paranoidi/gearplate/bracket.scad

// Device end caps for gearplate
// A pair of caps that screw onto the gearplate's 14mm insert grid, one over each end of
// a box-shaped device. Seen from the end, each cap is a hat:
//
//     |------------|      front strap over the device face
//     |  ________  |      end wall, with optional notches open from the plate side
// ----|  |      |  |----  flanges with screws, outboard (screwdriver clears the walls)
//
// Output is in print orientation: both caps lying on their end wall, side by side.

// Device width in mm
device_w = 60;
// Device height (distance between the two caps) in mm
device_h = 100;
// Device depth (plate to front face) in mm
device_d = 25;
// Clearance per side around the device
fit = 0.5;
// Widen the caps by one hole pitch when needed, so the device centres on the plate (D30)
center_x = false;
// Wall, end wall and strap thickness
wall = 3;
// Flange thickness
flange_t = 4;
// How far a cap reaches along the device, end wall included (grows if a screw needs room)
cap_len = 15;
// Screw clearance hole (M3)
screw_d = 3.4;
// Screwdriver / screw head clearance diameter
driver_d = 7;
// Extra margin around the screwdriver
driver_margin = 1;
// Chamfer on all outside edges, holes and notches (0 = sharp)
chamfer = 0.4;

/* [Cutouts, cap A] */
// End-wall notches [w, h, x_offset], open from the plate side, seen from outside with
// the strap on top: x_offset 0 = centred, + = right. [0,0,0] = off.
a_cut1 = [0, 0, 0];
a_cut2 = [0, 0, 0];
a_cut3 = [0, 0, 0];
a_cut4 = [0, 0, 0];

/* [Cutouts, cap B] */
b_cut1 = [0, 0, 0];
b_cut2 = [0, 0, 0];
b_cut3 = [0, 0, 0];
b_cut4 = [0, 0, 0];

/* [Top cutouts] */
// Window in the front strap [w, l, x_offset], open through the cap's end: w across,
// l along the device from its end, x_offset as for notches. [0,0,0] = off. Combines
// with end-wall notches. The cap grows to keep a strap band of at least `top_band` past
// the window.
a_top = [0, 0, 0];
b_top = [0, 0, 0];

/* [Hidden] */
pitch = 14;
// gearplate's board edge gap: flanges reach pitch/2 - edge_gap past the screw, flush
// with the plate edge when a cap sits on the edge hole row
edge_gap = 0.3;
// minimum strap band left past a top cutout
top_band = 15;
$fs = 0.5;
$fa = 5;

// Distance between the left and right hole rows: the smallest multiple of the hole
// pitch that leaves `clear` between each side wall and its screw centre, so both rows
// land on the gearplate grid. center_x makes the count odd (+1 pitch, 7 mm more flange per
// side): a plate has an even number of hole columns, so only an odd span centres on it.
function hole_span(inner_w, wall, clear) = let (k = ceil((inner_w + 2*wall + 2*clear) / pitch))
    pitch * (k + (center_x && k % 2 == 0 ? 1 : 0));
// Side wall outer face -> screw centre.
function hole_off(inner_w, wall, clear) = (hole_span(inner_w, wall, clear) - inner_w) / 2 - wall;
// End wall inner face -> first screw, [cap A, cap B], each >= t_min. Cap A's end wall
// reaches pitch/2 - edge_gap past its screw (+ whole pitches), so it can sit flush with
// the plate edge like the flanges (D20); cap B takes the rest, keeping the two screw
// rows a multiple of the pitch apart.
function cap_hole_t(inner_h, wall, t_min) =
    let (t0 = pitch/2 - edge_gap - wall, ta = t0 + pitch * max(0, ceil((t_min - t0) / pitch - 1e-9)))
    [ta, inner_h - ta - pitch * floor((inner_h - ta - t_min) / pitch + 1e-9)];

clear = driver_d/2 + driver_margin;
inner_w = device_w + 2*fit;
in_d = device_d + fit;
inner_h = device_h + fit;
off = hole_off(inner_w, wall, clear);
t_min = max(0, clear - wall);
t = cap_hole_t(inner_h, wall, t_min);
tops = [a_top, b_top];
clen = [for (b = [0, 1]) max(cap_len, wall + t[b] + clear, tops[b] == [0, 0, 0] ? 0 : wall + tops[b][1] + top_band)];
hole_zs = [for (b = [0, 1]) [for (z = [wall + t[b] : pitch : clen[b] - clear]) z]];
flange_w = off + max(clear, pitch/2 - edge_gap);
outer_w = inner_w + 2*wall;
wall_h = in_d + wall;

assert(device_w > 0 && device_h > 0 && device_d > 0, "device dimensions must be > 0");
assert(inner_h >= t[0] + t_min, "device_h too small for the screw spacing");
assert(chamfer >= 0 && chamfer < min(wall, flange_t) / 2, "chamfer must be >= 0 and < half the wall/flange");

cuts = [[a_cut1, a_cut2, a_cut3, a_cut4], [b_cut1, b_cut2, b_cut3, b_cut4]];
for (b = [0, 1], k = [0 : 3]) let (c = cuts[b][k], name = str(b ? "b" : "a", "_cut", k+1))
    if (c != [0, 0, 0]) {
        assert(len(c) == 3, str(name, " must be [w, h, x_offset]"));
        assert(c[0] > 0 && c[1] > 0 && abs(c[2]) + c[0]/2 <= inner_w/2 && c[1] <= in_d,
               str(name, " must fit inside the end wall (", inner_w, " wide, ", in_d, " high)"));
    }
for (b = [0, 1]) let (c = tops[b], name = str(b ? "b" : "a", "_top"))
    if (c != [0, 0, 0]) {
        assert(len(c) == 3, str(name, " must be [w, l, x_offset]"));
        assert(c[0] > 0 && c[1] > 0 && abs(c[2]) + c[0]/2 <= inner_w/2,
               str(name, " must fit between the side walls (", inner_w, " wide)"));
    }

echo(str("Cap hole rows are ", hole_span(inner_w, wall, clear) / pitch, " holes apart across; ",
         "cap A and cap B screws are ", (inner_h - t[0] - t[1]) / pitch, " holes apart along the device"));

// x across the device (0 = inner face of the left side wall), y up from the plate,
// z along the device from the end wall's outer face (print bed).
// Boxes [origin, size]. They overlap at joints (flanges reach into the side walls), so
// every face is either outside or buried and the chamfer leaves no grooves at seams.
function boxes(clen) = [
    [[-wall, 0, 0], [outer_w, wall_h, wall]],                                  // end wall
    [[-wall, 0, 0], [wall, wall_h, clen]],                                     // side walls
    [[inner_w, 0, 0], [wall, wall_h, clen]],
    [[-wall, in_d, 0], [outer_w, wall, clen]],                                 // front strap
    [[-wall - flange_w, 0, 0], [flange_w + wall/2, flange_t, clen]],           // flanges
    [[inner_w + wall/2, 0, 0], [flange_w + wall/2, flange_t, clen]],
];

module octahedron(r) polyhedron([[r,0,0], [-r,0,0], [0,r,0], [0,-r,0], [0,0,r], [0,0,-r]],
    [[4,2,0], [4,1,2], [4,3,1], [4,0,3], [5,0,2], [5,2,1], [5,1,3], [5,3,0]]);

// Union of boxes with every convex edge chamfered by `ch`: shrink each box by ch, then
// grow back with an octahedron. Inside corners stay sharp.
module chamfered_boxes(ch, clen) {
    // explicit union: under lazy-union (assembly export) a bare for would be
    // minkowski'd box by box into one big block
    if (ch > 0) minkowski() {
        union() for (b = boxes(clen)) translate(b[0] + ch*[1, 1, 1]) cube(b[1] - 2*ch*[1, 1, 1]);
        octahedron(ch);
    }
    else for (b = boxes(clen)) translate(b[0]) cube(b[1]);
}

// b: 0 = cap A, 1 = cap B
module cap(b) {
    cutouts = cuts[b];
    eps = 0.01;
    ch = chamfer;
    difference() {
        chamfered_boxes(ch, clen[b]);
        // screw holes, chamfered at both ends
        for (x = [-wall - off, inner_w + wall + off], z = hole_zs[b]) translate([x, 0, z]) rotate([-90, 0, 0]) {
            translate([0, 0, -eps]) cylinder(d=screw_d, h=flange_t + 2*eps);
            translate([0, 0, -eps]) cylinder(d1=screw_d + 2*(ch + eps), d2=screw_d, h=ch + eps);
            translate([0, 0, flange_t - ch]) cylinder(d1=screw_d, d2=screw_d + 2*(ch + eps), h=ch + eps);
        }
        // end-wall notches; the print bed view is from below, so +x_offset (right, seen
        // from outside) is -x here. Hulls of a face-sized and an inset slab chamfer the
        // notch edges on both end-wall faces and on the plate side.
        for (c = cutouts) if (c != [0, 0, 0]) let (x0 = inner_w/2 - c[2] - c[0]/2, w = c[0], h = c[1]) {
            translate([x0, -1, -1]) cube([w, h + 1, wall + 2]);
            for (z = [0, wall]) hull() {
                translate([x0 - ch, -1, z - eps]) cube([w + 2*ch, h + 1 + ch, 2*eps]);
                translate([x0, -1, z + (z == 0 ? ch : -ch) - eps]) cube([w, h + 1, 2*eps]);
            }
            hull() {
                translate([x0 - ch, -eps, -1]) cube([w + 2*ch, 2*eps, wall + 2]);
                translate([x0, ch - eps, -1]) cube([w, 2*eps, wall + 2]);
            }
        }
        // top cutout: strap window open through the end, l past the end wall's inner
        // face; the end wall below it is cut down to the device face. Chamfered on both
        // strap faces, the end wall's outer face and the cut-down end wall's inner edge.
        let (c = tops[b]) if (c != [0, 0, 0]) let (x0 = inner_w/2 - c[2] - c[0]/2, w = c[0], l = c[1]) {
            translate([x0, in_d, -1]) cube([w, wall + 1, wall + l + 1]);
            hull() {
                translate([x0 - ch, wall_h - eps, -1]) cube([w + 2*ch, 2*eps, wall + l + 1 + ch]);
                translate([x0, wall_h - ch - eps, -1]) cube([w, 2*eps, wall + l + 1]);
            }
            hull() {
                translate([x0 - ch, in_d - ch, -eps]) cube([w + 2*ch, wall + 1 + ch, 2*eps]);
                translate([x0, in_d, ch - eps]) cube([w, wall + 1, 2*eps]);
            }
            hull() {  // strap inner face; starts at the end wall so its top isn't grooved
                translate([x0 - ch, in_d - eps, wall]) cube([w + 2*ch, 2*eps, l + ch]);
                translate([x0, in_d + ch - eps, wall]) cube([w, 2*eps, l]);
            }
            hull() {  // cut-down end wall's inner top edge (air if a notch removed it)
                translate([x0, in_d - ch, wall - eps]) cube([w, ch + 1, 2*eps]);
                translate([x0, in_d - eps, wall - ch]) cube([w, 1, ch]);
            }
        }
    }
}

if (is_undef(assembly)) {  // assembly.scad places them itself
    cap(0);
    translate([outer_w + 2*flange_w + 5, 0, 0]) cap(1);
}
