paranoidi/gearplate/opengrid-snap.scad

// Vendored from https://github.com/nnarain/opengrid-snap-mount-generator
// (scad/opengrid-snap.scad @ c9a1339), unmodified below this line.
/* 
OpenGrid Snap
Design by David D
OpenSCAD by metasyntactic

This code is Licensed Creative Commons 4.0 Attribution Non-Commercial Share-Alike (CC-BY)
Derived parts are licensed Creative Commons 4.0 Attribution (CC-BY)

Change Log:
- 2025- 
    - Initial release

Credit to 
    @David D on Printables for openGrid
    Katie and her community at Hands on Katie on Youtube, Patreon, and Discord
*/

include <BOSL2/std.scad>

module openGridSnap(lite=false, directional=false, orient, anchor, spin){
	module openGridSnapNub(w, nub_h, nub_w, nub_d, b_y, top_wedge_h, bot_wedge_h, r_x, r_r, r_s){
		move([w/2, 0, 0])
		intersection(){
			difference(){
				//bounding box - add 0.01 to height for overlap with core
				zmove(nub_h-0.01) cuboid([nub_d,nub_w,2-nub_h+0.01], anchor=CENTER+LEFT+BOTTOM) ;
				//top part
				zmove(2) rotate([0,180,90]) wedge([nub_w,nub_d,top_wedge_h], anchor=CENTER+BOTTOM+BACK);
				//bottom part
				zmove(nub_h) rotate([0,0,90]) ymove(b_y) wedge([nub_w,0.4,bot_wedge_h], anchor=CENTER+BOTTOM+BACK);
			};
			//rounding - add 0.01 to height for overlap
			xmove(r_x) yscale(r_s) cyl($fn=600, r=r_r, h=2.01, anchor=BOTTOM);
		};
	}

	w=24.80;
	fulldiff=3.4;
	h=lite ? 3.4 : fulldiff*2;
	attachable(orient=orient, anchor=anchor, spin=spin, size=[w,w,h]){
		zmove(-h/2) difference(){
			core=3 + (lite ? 0 : fulldiff);
			top_h=0.4; 
			top_nub_h=1.1;

			union() {
				//top
				zmove(h-top_h-0.01) cuboid([w,w,top_h+0.01], rounding=3.262743, edges="Z", $fn=2, anchor=BOTTOM);
				// core
				cuboid([w,w,core], rounding=4.81837, edges="Z", $fn=2, anchor=BOTTOM);
				//top nub
				offs=2.02;
				intersection(){
					zmove(core-top_nub_h-0.01) cuboid([w,w,top_nub_h+0.01], rounding=3.262743, edges="Z", $fn=2, anchor=BOTTOM);
					zrot_copies(n=4) move([w/2-offs,w/2-offs,core]) rotate([180, 0, 135]) wedge(size=[6.817,top_nub_h,top_nub_h], anchor=CENTER+BOTTOM);
				};
				//bottom nub
				zmove(lite ? 0 : fulldiff) zrot_copies(n=4)
					if (!directional || ($idx==1 || $idx==3))
					openGridSnapNub(
						w=w,
						nub_h=0.2,
						nub_w=11,
						nub_d=0.4,
						top_wedge_h=0.6,
						bot_wedge_h=0.6,
						r_x=-12.36,
						r_s=1.36,
						r_r=13.025,
						b_y=-0
					);
				//directional nubs 
				 if (directional) {
					//front directional nub
					zmove(lite ? 0 : fulldiff) openGridSnapNub(
						w=w,
						nub_h=0,
						nub_w=14,
						nub_d=0.8,
						top_wedge_h=1.0,
						bot_wedge_h=0.4,
						r_x=-11.75,
						r_s=1.26,
						r_r=13.025,
						b_y=-0.4
					);
					 
					//rear directional nub
					zrot(180) zmove(lite ? 0 : fulldiff) openGridSnapNub(
						w=w,
						nub_h=0.65,
						nub_w=10.8,
						nub_d=0.4,
						top_wedge_h=0.6,
						bot_wedge_h=0.6,
						r_x=-12.41,
						r_s=1.37,
						r_r=13.025,
						b_y=0
					);
				};
			};
			//bottom click holes
			zrot_copies(n=4)
				move([w/2-1, 0, 0])
				if (!directional || $idx==1 || $idx==3)
					cuboid([0.6,12.4,2.8 + (lite ? 0 : fulldiff)], rounding=0.3, $fn=100, edges="Z", anchor=BOTTOM);
			//bottom click holes for rear directional
			if (directional) {
				zrot(180) move([w/2-1, 0, 0.599]) cuboid([0.6, 12.4, 2.2 + (lite ? 0 : fulldiff) ], rounding=0.3, $fn=100, edges="Z", anchor=BOTTOM);
				zrot(180) move([w/2-1.2, 0, 0]) prismoid(size1=[0.6, 12.4], size2=[0.6, 12.4], h=0.6, shift=[0.2,0], rounding=0.3, $fn=100);
				zrot(180) move([w/2-0.1, 0, 0]) rotate([0,0,0]) prismoid(size1=[0.2, 20], size2=[0, 20], shift=[0.1,0], h=0.6, anchor=BOTTOM);
			};

			//bottom wall click holes
			zrot_copies(n=4)
				move([w/2, 0, 2.2 + (lite ? 0 : fulldiff)])
				if (!directional || ($idx>0))
					cuboid([1.4,12,0.4], anchor=BOTTOM);

			//directional indicator
			if (directional) move([9.5,0,0]) cylinder(r1=2, r2=1.5, h=0.4, $fn=2);
		};
		children();
	};
};

//openGridSnap(lite=true, directional=true); 
