paranoidi/gearplate/(commit log)

2026-10-12 Add openGrid device board generator
    Parametric OpenSCAD board sized in openGrid cells, with M3 heat-set
    insert holes on a lattice-aligned 14mm pitch (continuous across adjacent
    boards) and fused corner snaps on optional posts.
    - gearplate.scad: generator, reuses openGridSnap() from reference/
    - gearplate.json: Customizer presets
    - Taskfile.yml: build presets to out/, one-off builds, tests
    - tests/seam.scad: hole seam continuity and snap de-dup asserts
    - DESIGN.md: living design reference
    [gearplate.scad, seam.scad]
2026-10-12 Vendor opengrid-snap.scad, drop dependency on reference/
    Copy of scad/opengrid-snap.scad from nnarain/opengrid-snap-mount-generator
    @ c9a1339, unmodified apart from a provenance header (CC-BY-NC-SA 4.0).
    [gearplate.scad, opengrid-snap.scad]
2026-10-12 Add cable routing slots
    Up to 8 rounded through-slots (slot1..slot8 = [x1,y1,x2,y2]) in hole-grid
    indices seen from the device face. -1 / 2*cells reach past an edge so the
    slot opens out of the board. Default r=7 (one hole pitch wide). Slots that
    would overlap a corner snap fail with an assert.
    [gearplate.scad, slots.scad]
2026-10-12 Add task setup: OpenSCAD nightly (Manifold) + BOSL2 in .tools/
    Tasks pick $OPENSCAD, then .tools/openscad --backend=Manifold, then system
    openscad. Full preset build drops from ~75s to ~6s. Tests now export .echo
    and grep for errors, since BOSL2's cube() override broke the cube(1)
    placeholder under use<> and .echo export exits 0 on failed asserts.
    [seam.scad, slots.scad]
2026-10-12 Change 4x4-slots preset to a single diagonal slot
2026-10-12 Fix sharp spikes where slots meet the board edge
    Slot ends on the edge row (or given as -1 / 2*cells) now get a straight
    extension out through the edge, along the circle's tangents, instead of
    the circle grazing the edge and leaving a thin sliver. Extensions are
    included in the corner-snap overlap check. Adds preset 4x4-edge-slots.
    [gearplate.scad, slots.scad]
2026-10-12 Replace 4x4-edge-slots preset with 4x4-mixed-slots
2026-10-12 Add device end caps (bracket.scad)
    Two hat-profile caps, one over each end of a device: outboard screw flanges
    snapped to the 14mm grid with screwdriver clearance, side walls, front strap,
    and an end wall that is the print base. Per-cap end-wall notch cutouts
    [w, h, x_offset]. task stl finds the preset in gearplate.json or bracket.json.
    [bracket.scad]
2026-10-12 Chamfer all end cap edges (0.4 mm)
    Outside edges via minkowski of shrunk overlapping boxes with an octahedron;
    screw holes and end-wall notches get chamfered cutters. New chamfer parameter.
    [bracket.scad]
2026-10-12 Chamfer board edges and cable slot rims (0.4 mm)
    Board is a hull of inset octahedra (all edges, vertical corners included).
    Slot cutters hull the straight wall and each face flare separately so the
    chamfer doesn't fill the whole slot out to r + c. Snap-overlap check uses
    slot_r + chamfer.
    [gearplate.scad]
2026-10-12 Add plate presets up to 9x9, drop 1-wide sizes
    One preset per size pair from 2x2 to 9x9 (rotations not duplicated).
    1-wide plates are too small to be useful; still buildable via task custom.
2026-10-12 Shape posts like the openGrid snap
    Posts use the snap's top-plate outline (24.8 mm square, 45° corner cuts,
    same BOSL2 cuboid as opengrid-snap.scad) instead of a Ø18 cylinder.
    post_diameter removed.
    [gearplate.scad]
2026-10-12 Add assembly fit check (plate + caps + device block)
    assembly.scad includes both models, snaps the caps to plate holes
    near the centre, and shows the device as a block. Built by
    `task assembly` (STL + coloured PNG), checked by tests/assembly.scad.
    [assembly.scad, bracket.scad, gearplate.scad]
2026-10-12 Extend cap flanges flush to the plate edge
    [bracket.scad]
2026-10-12 Export assembly as 3MF with one object per part
    The STL export unioned the touching parts into one mesh that slicers
    could not split. Export 3MF with lazy-union instead, one top-level
    statement per part. Wrap the cap's box loop in union() so minkowski
    still chamfers the union under lazy-union.
    [assembly.scad, bracket.scad]
2026-10-13 Add stacking piece: 1x1 openGrid tile on a floor with gearplate screw holes
    Countersunk or counterbored M3 holes on the 14 mm hole pattern, 0.4 mm
    outer chamfer, Full/Lite tile. Vendors QuackWorks openGrid.scad as
    opengrid-tile.scad.
    [opengrid-tile.scad, stacking.scad]
2026-10-13 Add task fit: smallest assembly per named device
    Prompts for a device name, size and cap cutouts, saves the answers to
    devices/<name>/<name>.json (hand-editable, rebuilt by task device D=<name>
    or task), and builds assembly, plate and caps into that directory. The
    assembly plate now defaults to the smallest that keeps the cap footprint
    on the board.
    [assembly.scad]
2026-10-19 Chamfer insert holes
    [gearplate.scad]
2026-10-20 Make caps asymmetric so plates can be a cell shorter
    Cap A's end wall now reaches pitch/2 - edge_gap past its screw, so it sits
    flush on the plate edge; cap B takes the rest. Cloudkey 3x6 -> 3x5, default
    device 4x5 -> 4x4. Adds the cloudkey device answers.
    [assembly.scad, bracket.scad]
2026-10-20 Add holed snap: openGrid snap with 2x2 gearplate insert holes
    [snap.scad]
2026-10-21 Add sparse holes option (full_holes) to cut plate print time
    full_holes = false keeps only the corner-cell holes (for posts) plus the
    assembly's cap screw holes. task fit asks "Reusable plate (full holes)".
    cloudkey switched to sparse holes.
    [assembly.scad, gearplate.scad]
2026-10-31 Rename tasks: fit -> device, device -> device:build
    `task device` now creates/edits a device interactively; rebuilding one
    from its JSON is `task device:build D=<name>`.
2026-10-31 Add top cutout to device caps; add unifi-8-60w device
    a_top/b_top = [w, l, x_offset]: a strap window open through the cap's
    end (e.g. to keep switch LEDs visible), combinable with end-wall notches.
    The cap grows to keep at least top_band (15 mm) of strap past the window,
    and every window edge is chamfered. task device asks for it per cap.
    [bracket.scad]
2026-11-01 Add plate margins, wire slots, edit-device and spec.png
    Plate margins (margin_a/b/l/r) are whole openGrid cells added to the
    smallest plate on each side; the device keeps its place. task device now
    prints a hole map (task device:check) and asks for wire slots against it.
    A slot may not cut a cap screw hole.
    The prompts moved from Taskfile.yml to device.sh and write each answer
    into the device JSON as given, so hand-added keys survive a re-run.
    task edit-device asks the same questions for an existing device.
    spec.py draws each device's spec.png (hole coordinates, caps, margins,
    slots) from a Spec echo in assembly.scad, and docs/coordinates.png for
    the README. python3 and rsvg-convert/inksca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
    [assembly.scad, margin.scad]
2026-11-01 Clearer hole map, per-section device edits, safer slot prompts
    - Hole map: device as an X block, caps as A/B blocks, S for snaps under
    them, O slots, + cap screws, legend; no "Map:" prefix in task output.
    - task edit-size / edit-cap-a / edit-cap-b / edit-margin / edit-slots
    (one edit-* wildcard, device.sh --only <section>).
    - Margin questions show the current map first and say "openGrid cells".
    - Slot prompts take map indices only (no -1 / 2*cells; edge rows already
    open out, D12), re-ask on off-map or rejected slots, and show the map
    without saved slots when those break the check.
    - Progress messages ending in "..." for slow check/build steps.
    - unifi-8-60w: margins, slots and top c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
    [assembly.scad]
2026-11-01 feat(device): ask for post height and let q skip remaining questions
2026-11-01 feat(bracket): add center_x option to centre device on plate
    Widens both caps by one hole pitch when the screw span would leave a spare hole column on one side. Adds tests/center.scad and a device.sh prompt.
    [bracket.scad, center.scad]
2026-11-01 docs: README hero from unifi-8-60w device, add its spec drawing
2026-11-01 feat(plate): add solid first layer over insert holes
    Optional solid_first_layer (default off) closes the insert holes on the device face with a first_layer-high skin, for a cleaner face and better bed grip. The insert pushes through the skin. device.sh asks for it in the size section.
    [gearplate.scad]
